Matthew-B549/Custom-Handheld-Console/Hardware/V1/handheldConsoleV1.kicad_pcb

## KiCad design Hardware/V1/handheldConsoleV1.kicad_pcb (2026-11-11, an earlier design)

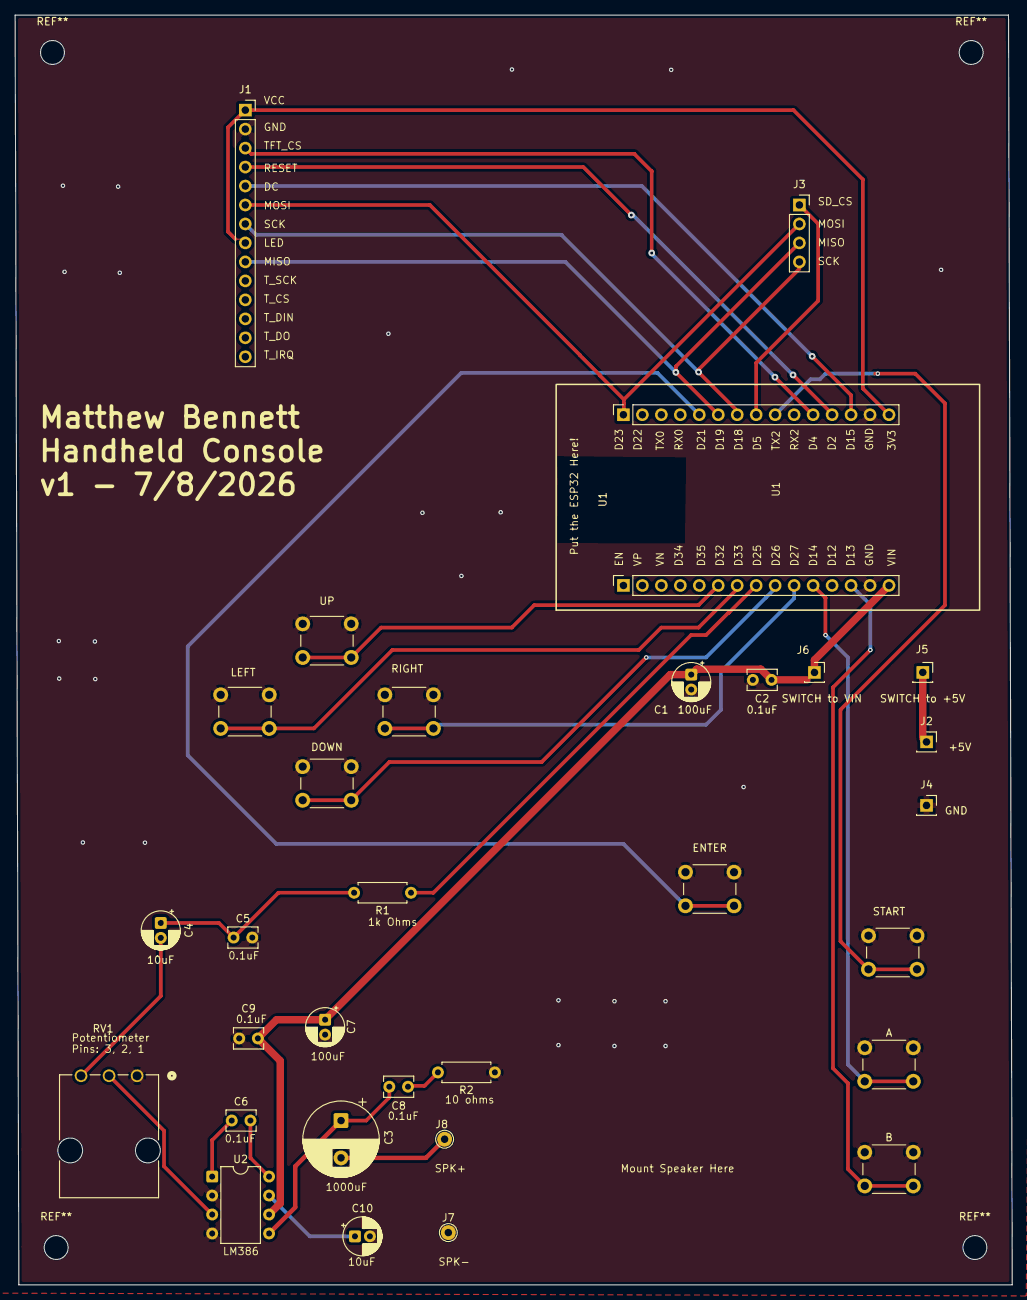
[picture p1: board handheldConsoleV1.kicad_pcb from above]

Board: 2 copper layers, 133.5 x 170.0 mm, 31 parts (0 on the bottom side), 29 nets.

Parts:
A: SW_Push; SW_PUSH_6mm_H4.3mm
B: SW_Push; SW_PUSH_6mm_H4.3mm
C1, C7: 100uF; CP_Radial_D5.0mm_P2.00mm
C2, C5, C6, C8, C9: 0.1uF; C_Disc_D3.8mm_W2.6mm_P2.50mm
C3: 1000uF; CP_Radial_D10.0mm_P5.00mm
C4, C10: 10uF; CP_Radial_D5.0mm_P2.00mm
DOWN: SW_Push; SW_PUSH_6mm_H4.3mm
ENTER: SW_Push; SW_PUSH_6mm_H4.3mm
J1: Conn_01x14_Socket; PinSocket_1x14_P2.54mm_Vertical
J2, J4, J5, J6: Conn_01x01_Socket; PinSocket_1x01_P2.54mm_Vertical
J3: Conn_01x04_Socket; PinSocket_1x04_P2.54mm_Vertical
J7, J8: Conn_01x01; TestPoint_THTPad_D2.0mm_Drill1.0mm
LEFT: SW_Push; SW_PUSH_6mm_H4.3mm
R1: 1k; R_Axial_DIN0207_L6.3mm_D2.5mm_P7.62mm_Horizontal
R2: 10; R_Axial_DIN0207_L6.3mm_D2.5mm_P7.62mm_Horizontal
RIGHT: SW_Push; SW_PUSH_6mm_H4.3mm
RV1: R_Potentiometer; POT_P120PK-x25_TTE
START: SW_Push; SW_PUSH_6mm_H4.3mm
U1: SocketsForEsp32
U2: LM386; DIP-8_W7.62mm
UP: SW_Push; SW_PUSH_6mm_H4.3mm

Connections:
+3V3: J1.1, J1.8, U1.16 (3.3v)
+5V: C1.1, C2.1, C7.1, C9.1, J6.1 (Pin_1_1), U1.1 (VIN), U2.6 (V+)
GND: A.1, B.1, C1.2, C2.2, C5.2, C7.2, C9.2, C10.2, DOWN.1, ENTER.1, J1.2, J4.1 (Pin_1_1), J7.1 (Pin_1_1), LEFT.1, R2.1, RIGHT.1, RV1.1, START.1, U1.2 (GND), U1.17 (GND), U2.2 (-), U2.4 (GND), UP.1
unnamed: C3.1, C8.2, U2.5
unnamed: C4.1, C5.1, R1.2
unnamed: C4.2, RV1.3
unnamed: C6.1, U2.1 (GAIN)
unnamed: C6.2, U2.8 (GAIN)
unnamed: C8.1, R2.2
unnamed: J1.3, U1.20 (GPIO4)
unnamed: J1.4, U1.19 (GPIO2)
unnamed: J1.5, U1.18 (GPIO15)
unnamed: J1.6, J3.2, U1.30 (GPIO23)
unnamed: J1.7, J3.4, U1.24 (GPIO18)
unnamed: J1.9, J3.3, U1.25 (GPIO19)
unnamed: J2.1 (Pin_1_1), J5.1 (Pin_1_1)
unnamed: J3.1, U1.23 (GPIO5)
unnamed: C3.2, J8.1 (Pin_1_1)
unnamed: B.2, U1.3 (GPIO13)
unnamed: A.2, U1.5 (GPIO14)
unnamed: START.2, U1.22 (GPIO17)
unnamed: ENTER.2, U1.26 (GPIO21)
unnamed: R1.1, U1.8 (GPIO25)
unnamed: DOWN.2, U1.7 (GPIO26)
unnamed: RIGHT.2, U1.6 (GPIO27)
unnamed: U1.10 (GPIO32), UP.2
unnamed: LEFT.2, U1.9 (GPIO33)
unnamed: RV1.2, U2.3 (+)
unnamed: C10.1, U2.7 (BYPASS)
