Matthew-B549/Custom-Handheld-Console/Hardware/V2/handheldConsoleV2.kicad_pcb

## KiCad design Hardware/V2/handheldConsoleV2.kicad_pcb (2026-11-11)

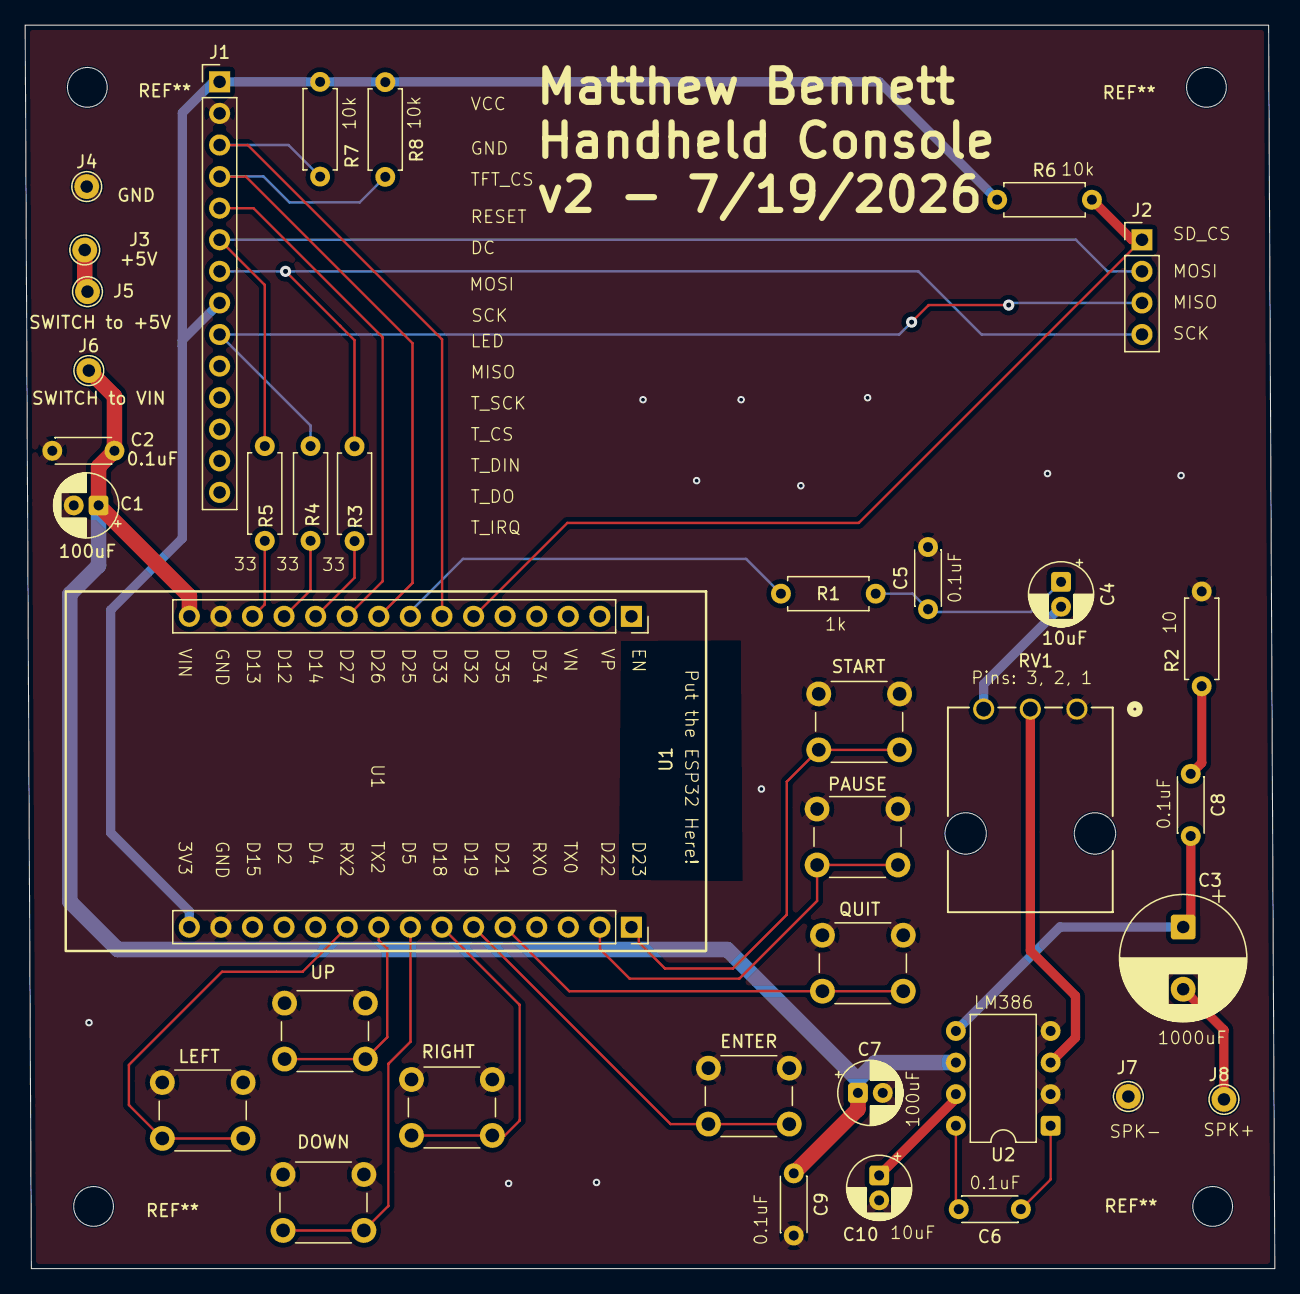
[picture p2: board handheldConsoleV2.kicad_pcb from above]

Board: 2 copper layers, 100.5 x 100.0 mm, 37 parts (0 on the bottom side), 32 nets.

Parts:
C1, C7: 100uF; CP_Radial_D5.0mm_P2.00mm
C2, C5, C6, C8, C9: 0.1uF; C_Disc_D4.3mm_W1.9mm_P5.00mm
C3: 1000uF; CP_Radial_D10.0mm_P5.00mm
C4, C10: 10uF; CP_Radial_D5.0mm_P2.00mm
DOWN: SW_Push; SW_PUSH_6mm_H4.3mm
ENTER: SW_Push; SW_PUSH_6mm_H4.3mm
J1: Screen_Pins; PinHeader_1x14_P2.54mm_Vertical
J2: SD_Pins; PinHeader_1x04_P2.54mm_Vertical
J3, J4, J5, J6, J7, J8: Conn_01x01; TestPoint_THTPad_D2.0mm_Drill1.0mm
LEFT: SW_Push; SW_PUSH_6mm_H4.3mm
PAUSE: SW_Push; SW_PUSH_6mm_H4.3mm
QUIT: SW_Push; SW_PUSH_6mm_H4.3mm
R1: 1k; R_Axial_DIN0207_L6.3mm_D2.5mm_P7.62mm_Horizontal
R2: 10; R_Axial_DIN0207_L6.3mm_D2.5mm_P7.62mm_Horizontal
R3, R4, R5: 33; R_Axial_DIN0207_L6.3mm_D2.5mm_P7.62mm_Horizontal
R6, R7, R8: 10k; R_Axial_DIN0207_L6.3mm_D2.5mm_P7.62mm_Horizontal
RIGHT: SW_Push; SW_PUSH_6mm_H4.3mm
RV1: R_Potentiometer; POT_P120PK-x25_TTE
START: SW_Push; SW_PUSH_6mm_H4.3mm
U1: SocketsForEsp32
U2: LM386; DIP-8_W7.62mm
UP: SW_Push; SW_PUSH_6mm_H4.3mm

Connections:
+3V3: J1.1, J1.8, R6.1, R7.1, R8.1, U1.16 (3.3v)
+5V: C1.1, C2.1, C7.1, C9.1, J6.1 (Pin_1_1), U1.1 (VIN), U2.6 (V+)
/DAC_AUDIO: R1.1, U1.8 (GPIO25)
/DC: J1.5, U1.6 (GPIO27)
/DOWN_BTN: DOWN.2, U1.23 (GPIO5)
/ENTER_BTN: ENTER.2, U1.25 (GPIO19)
/LEFT_BTN: LEFT.2, U1.21 (GPIO16)
/MISO: J1.9, J2.3, R4.2
/MOSI: J1.6, J2.2, R5.2
/PAUSE_BTN: START.2, U1.30 (GPIO23)
/QUIT_BTN: PAUSE.2, U1.29 (GPIO22)
/RESET: J1.4, R8.2, U1.7 (GPIO26)
/RIGHT_BTN: RIGHT.2, U1.24 (GPIO18)
/SCK: J1.7, J2.4, R3.2
/SD_CS: J2.1, R6.2, U1.10 (GPIO32)
/START_BTN: QUIT.2, U1.26 (GPIO21)
/TFT_CS: J1.3, R7.2, U1.9 (GPIO33)
/UP_BTN: U1.22 (GPIO17), UP.2
GND: C1.2, C2.2, C5.2, C7.2, C9.2, C10.2, DOWN.1, ENTER.1, J1.2, J4.1 (Pin_1_1), J7.1 (Pin_1_1), LEFT.1, PAUSE.1, QUIT.1, R2.1, RIGHT.1, RV1.1, START.1, U1.2 (GND), U1.17 (GND), U2.2 (-), U2.4 (GND), UP.1
unnamed: C3.1, C8.2, U2.5
unnamed: C4.1, C5.1, R1.2
unnamed: C4.2, RV1.3
unnamed: C6.1, U2.1 (GAIN)
unnamed: C6.2, U2.8 (GAIN)
unnamed: C8.1, R2.2
unnamed: J3.1 (Pin_1_1), J5.1 (Pin_1_1)
unnamed: C3.2, J8.1 (Pin_1_1)
unnamed: R4.1, U1.4 (GPIO12)
unnamed: R5.1, U1.3 (GPIO13)
unnamed: R3.1, U1.5 (GPIO14)
unnamed: RV1.2, U2.3 (+)
unnamed: C10.1, U2.7 (BYPASS)
