Matthew-B549/Custom-Handheld-Console/Software/hitPaddle.h

// Audio Variable: hitPaddle
// Target Sample Rate: 8000 Hz
// Length: 1133 samples

#include <pgmspace.h>

const uint8_t hitPaddle_data[1133] PROGMEM = {
    0x8B, 0x99, 0x89, 0x85, 0x77, 0x74, 0x62, 0x80, 0x9D, 0x89, 0x87, 0x78,
    0x77, 0x65, 0x73, 0x9A, 0x92, 0x87, 0x82, 0x75, 0x74, 0x62, 0x7A, 0x9B,
    0x8F, 0x87, 0x81, 0x76, 0x73, 0x64, 0x75, 0x9D, 0x90, 0x8B, 0x81, 0x7C,
    0x72, 0x6F, 0x61, 0x83, 0x9D, 0x8B, 0x8B, 0x7E, 0x7C, 0x70, 0x70, 0x60,
    0x80, 0x9E, 0x8D, 0x8D, 0x80, 0x7F, 0x73, 0x72, 0x65, 0x6D, 0x9A, 0x97,
    0x8E, 0x8A, 0x81, 0x7D, 0x74, 0x70, 0x69, 0x66, 0x96, 0x9A, 0x8F, 0x8C,
    0x83, 0x7F, 0x78, 0x73, 0x6D, 0x67, 0x68, 0x9B, 0x97, 0x90, 0x8B, 0x84,
    0x80, 0x79, 0x75, 0x6D, 0x6C, 0x61, 0x8A, 0x9E, 0x92, 0x8F, 0x88, 0x83,
    0x7E, 0x78, 0x75, 0x6D, 0x6D, 0x5F, 0x7E, 0xA0, 0x93, 0x91, 0x8A, 0x86,
    0x80, 0x7B, 0x76, 0x72, 0x6D, 0x69, 0x62, 0x8E, 0xA0, 0x91, 0x93, 0x88,
    0x89, 0x7F, 0x7F, 0x76, 0x75, 0x6D, 0x6D, 0x65, 0x67, 0x98, 0x9B, 0x93,
    0x90, 0x8A, 0x86, 0x81, 0x7D, 0x79, 0x74, 0x72, 0x6A, 0x6B, 0x5F, 0x7E,
    0xA2, 0x94, 0x95, 0x8C, 0x8B, 0x84, 0x82, 0x7C, 0x7A, 0x73, 0x72, 0x6B,
    0x6C, 0x61, 0x72, 0xA0, 0x98, 0x95, 0x91, 0x8C, 0x88, 0x83, 0x81, 0x7B,
    0x79, 0x74, 0x72, 0x6C, 0x6A, 0x66, 0x64, 0x95, 0x9E, 0x94, 0x94, 0x8D,
    0x8B, 0x85, 0x83, 0x7E, 0x7B, 0x77, 0x74, 0x70, 0x6D, 0x6A, 0x67, 0x63,
    0x93, 0xA0, 0x95, 0x96, 0x8E, 0x8E, 0x86, 0x86, 0x7F, 0x7F, 0x78, 0x77,
    0x72, 0x70, 0x6C, 0x6A, 0x66, 0x64, 0x92, 0x9F, 0x96, 0x95, 0x8F, 0x8D,
    0x89, 0x85, 0x82, 0x7E, 0x7B, 0x77, 0x75, 0x70, 0x6F, 0x6A, 0x6A, 0x62,
    0x6F, 0x9F, 0x9B, 0x98, 0x94, 0x90, 0x8D, 0x89, 0x86, 0x82, 0x7F, 0x7B,
    0x79, 0x75, 0x73, 0x6E, 0x6E, 0x68, 0x69, 0x5F, 0x87, 0xA3, 0x96, 0x98,
    0x91, 0x90, 0x8A, 0x89, 0x84, 0x82, 0x7E, 0x7B, 0x78, 0x75, 0x73, 0x6E,
    0x6E, 0x68, 0x6A, 0x5F, 0x7D, 0xA2, 0x99, 0x98, 0x93, 0x90, 0x8D, 0x89,
    0x87, 0x82, 0x80, 0x7C, 0x7A, 0x76, 0x75, 0x70, 0x6F, 0x6A, 0x69, 0x65,
    0x65, 0x95, 0x9F, 0x97, 0x97, 0x91, 0x8F, 0x8B, 0x89, 0x85, 0x82, 0x7F,
    0x7C, 0x79, 0x76, 0x74, 0x70, 0x6E, 0x6A, 0x69, 0x65, 0x65, 0x98, 0x9F,
    0x97, 0x97, 0x91, 0x90, 0x8B, 0x89, 0x85, 0x82, 0x7F, 0x7C, 0x79, 0x76,
    0x73, 0x70, 0x6E, 0x6B, 0x68, 0x65, 0x64, 0x96, 0xA0, 0x97, 0x97, 0x91,
    0x90, 0x8B, 0x89, 0x85, 0x82, 0x7F, 0x7C, 0x79, 0x76, 0x74, 0x70, 0x6E,
    0x6A, 0x69, 0x64, 0x66, 0x97, 0x9F, 0x97, 0x97, 0x90, 0x90, 0x8A, 0x89,
    0x84, 0x82, 0x7E, 0x7C, 0x78, 0x75, 0x73, 0x6F, 0x6E, 0x68, 0x6A, 0x60,
    0x73, 0xA0, 0x9A, 0x98, 0x94, 0x90, 0x8E, 0x89, 0x87, 0x82, 0x81, 0x7C,
    0x7B, 0x76, 0x75, 0x70, 0x6F, 0x69, 0x6A, 0x62, 0x6C, 0x9C, 0x9C, 0x97,
    0x95, 0x90, 0x8E, 0x89, 0x88, 0x82, 0x81, 0x7C, 0x7B, 0x75, 0x75, 0x6F,
    0x6F, 0x68, 0x6A, 0x5F, 0x76, 0xA1, 0x99, 0x97, 0x92, 0x8F, 0x8C, 0x88,
    0x85, 0x81, 0x7E, 0x7B, 0x77, 0x75, 0x70, 0x6F, 0x69, 0x6A, 0x5F, 0x7A,
    0xA3, 0x97, 0x97, 0x91, 0x8F, 0x8B, 0x87, 0x84, 0x80, 0x7E, 0x78, 0x77,
    0x71, 0x71, 0x6A, 0x6B, 0x62, 0x6F, 0x9E, 0x9A, 0x97, 0x93, 0x8F, 0x8B,
    0x87, 0x84, 0x80, 0x7C, 0x78, 0x75, 0x71, 0x6F, 0x69, 0x69, 0x61, 0x8C,
    0xA0, 0x95, 0x95, 0x8F, 0x8D, 0x87, 0x84, 0x80, 0x7C, 0x79, 0x74, 0x72,
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
};
