Matthew-B549/Custom-Handheld-Console/(commit log)

2026-11-11 Added GERBER files for my PCB
2026-11-11 Added V2 Gerbers
2026-11-11 Move SocketsForEsp32.kicad_mod to V2 directory
2026-11-11 Move esp_footprint.kicad_mod to V2 directory
2026-11-11 Update README with project reflections and V1 to V2 changes
    Expanded on project details, including changes from V1 to V2 and personal reflections on the PCB design process.
2026-11-11 Fixed version
    [handheldConsoleV2.kicad_pcb]
2026-11-11 Document ESP32 footprint size issue in README
    Added note about ESP32 footprint issues affecting soldering.
